mspeculatrix/McROM/Documentation/img/McROM-prog-hdr.png

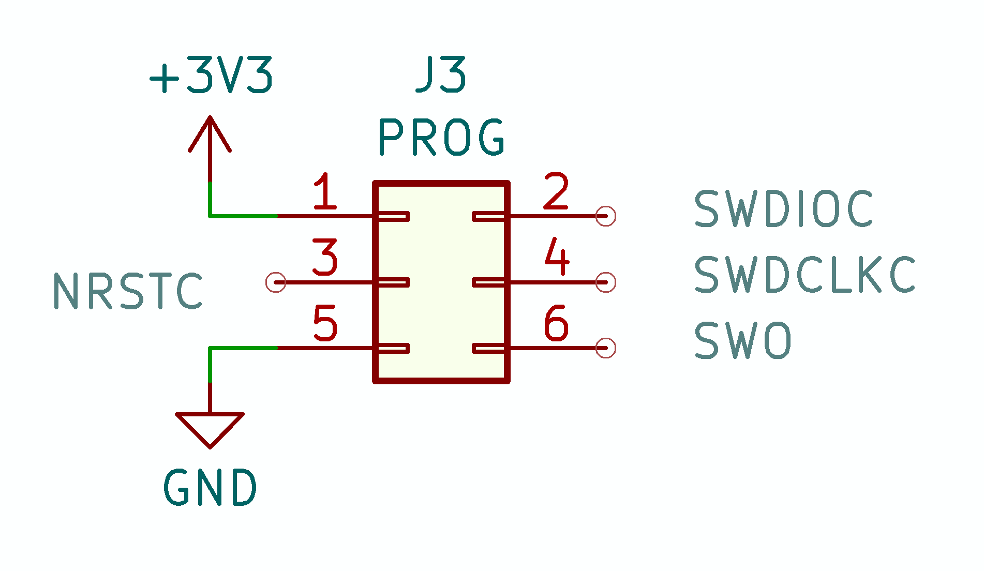
Documentation/img/McROM-prog-hdr.png
