mspeculatrix/McROM/Documentation/img/McROM-STM32H523CET-pinout.png

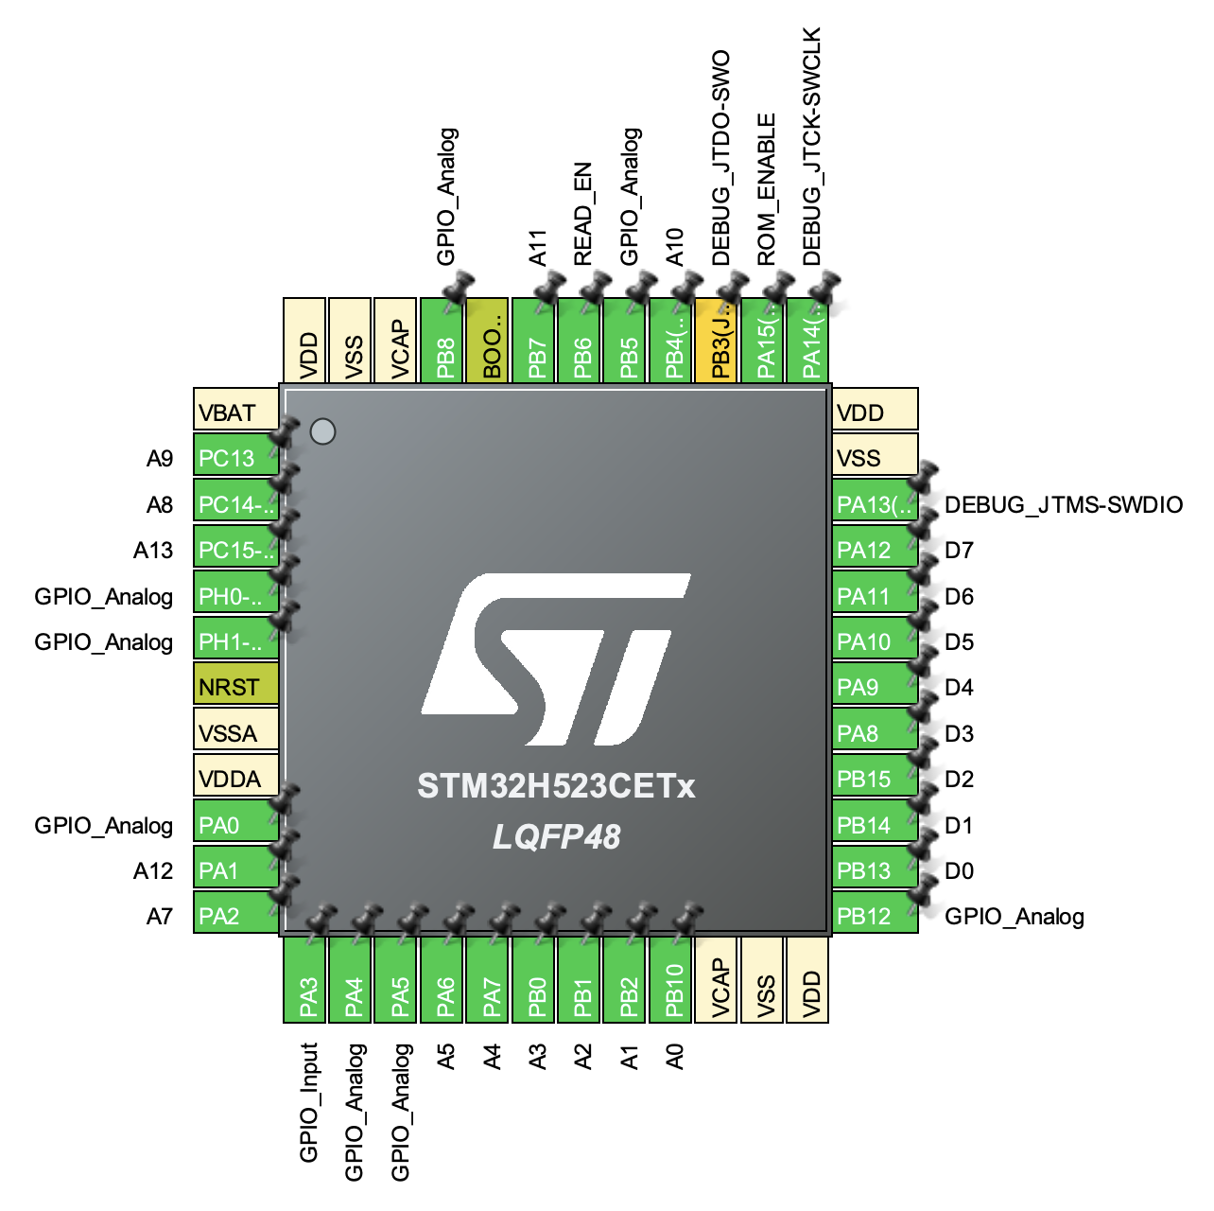
Documentation/img/McROM-STM32H523CET-pinout.png
