mspeculatrix/McROM/Documentation/img/McROM-SWD-header.png

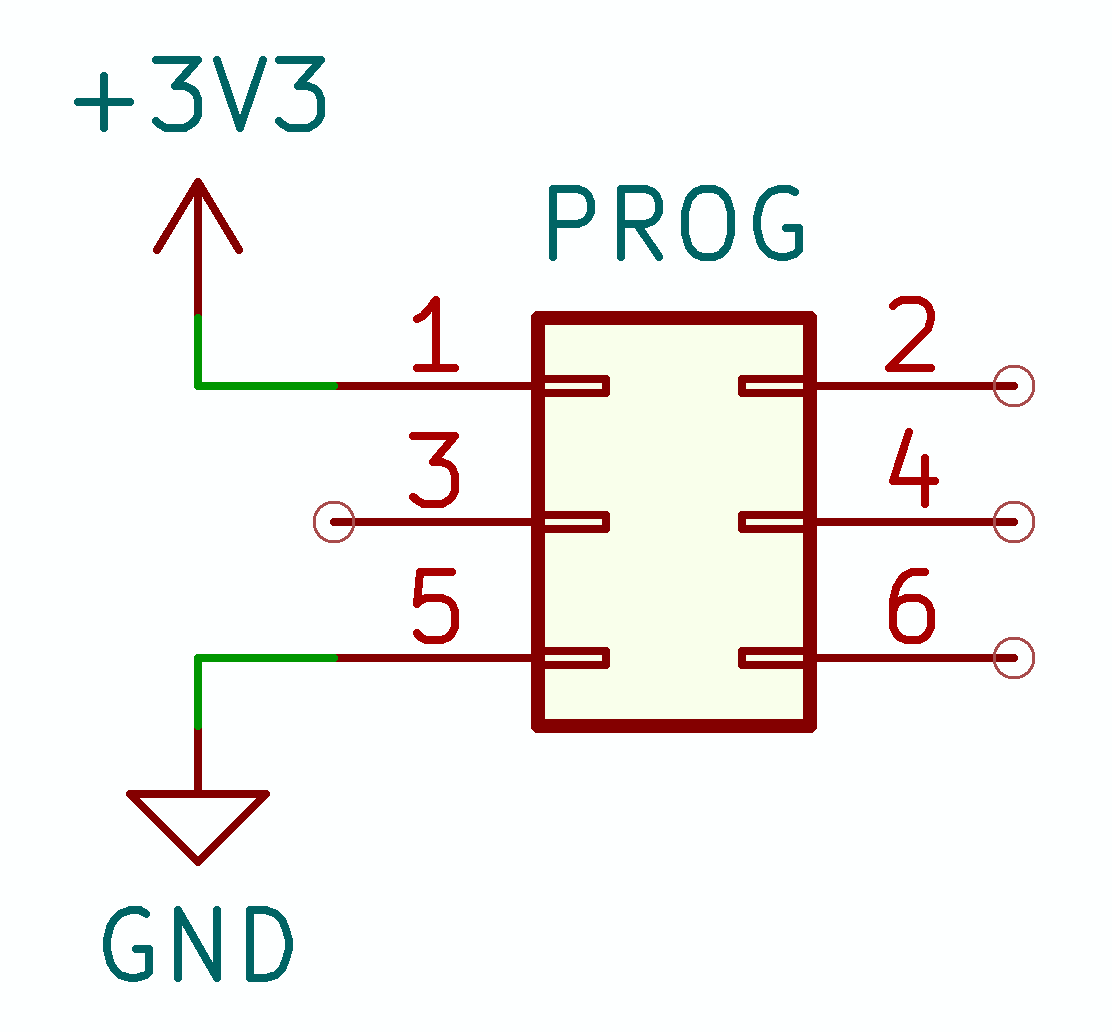
Documentation/img/McROM-SWD-header.png
