mspeculatrix/McROM/Documentation/img/Pin assignments.png

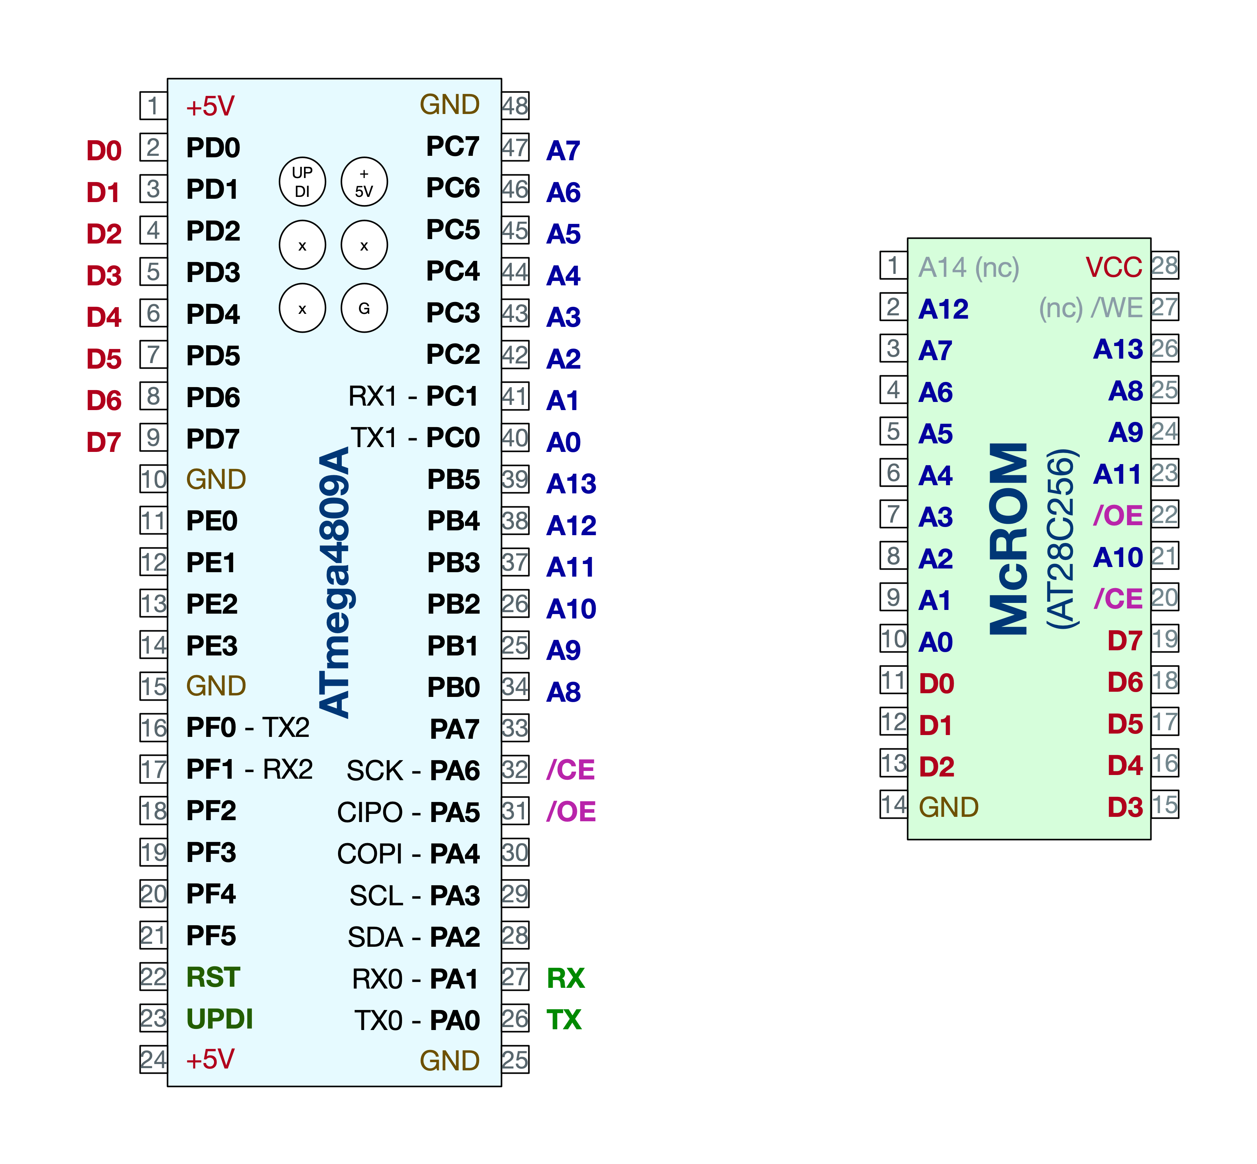
Documentation/img/Pin assignments.png
