mspeculatrix/McROM/Documentation/img/Programmer-connections.png

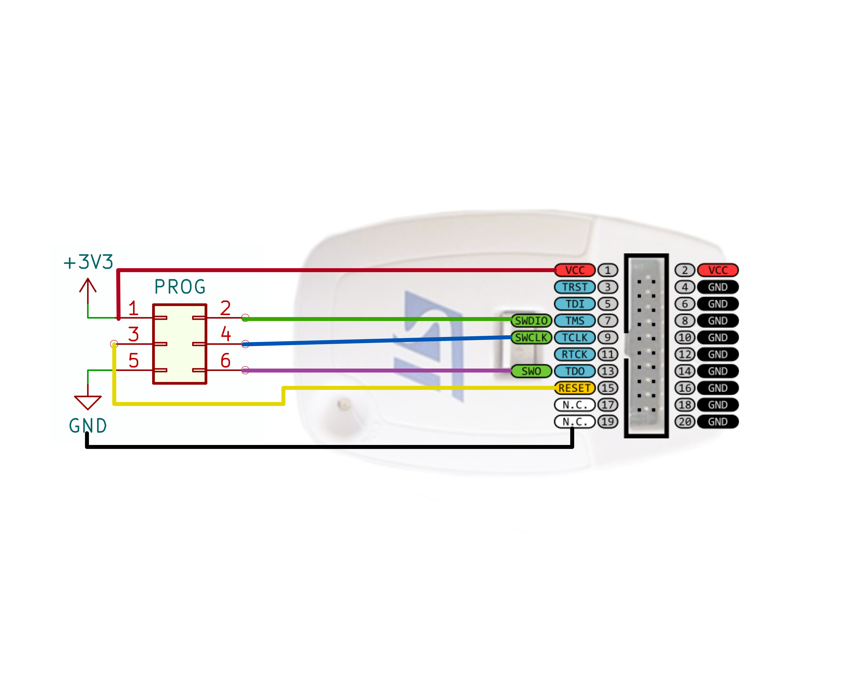
Documentation/img/Programmer-connections.png
