mspeculatrix/McROM/Documentation/McROM A1 schematic.jpg

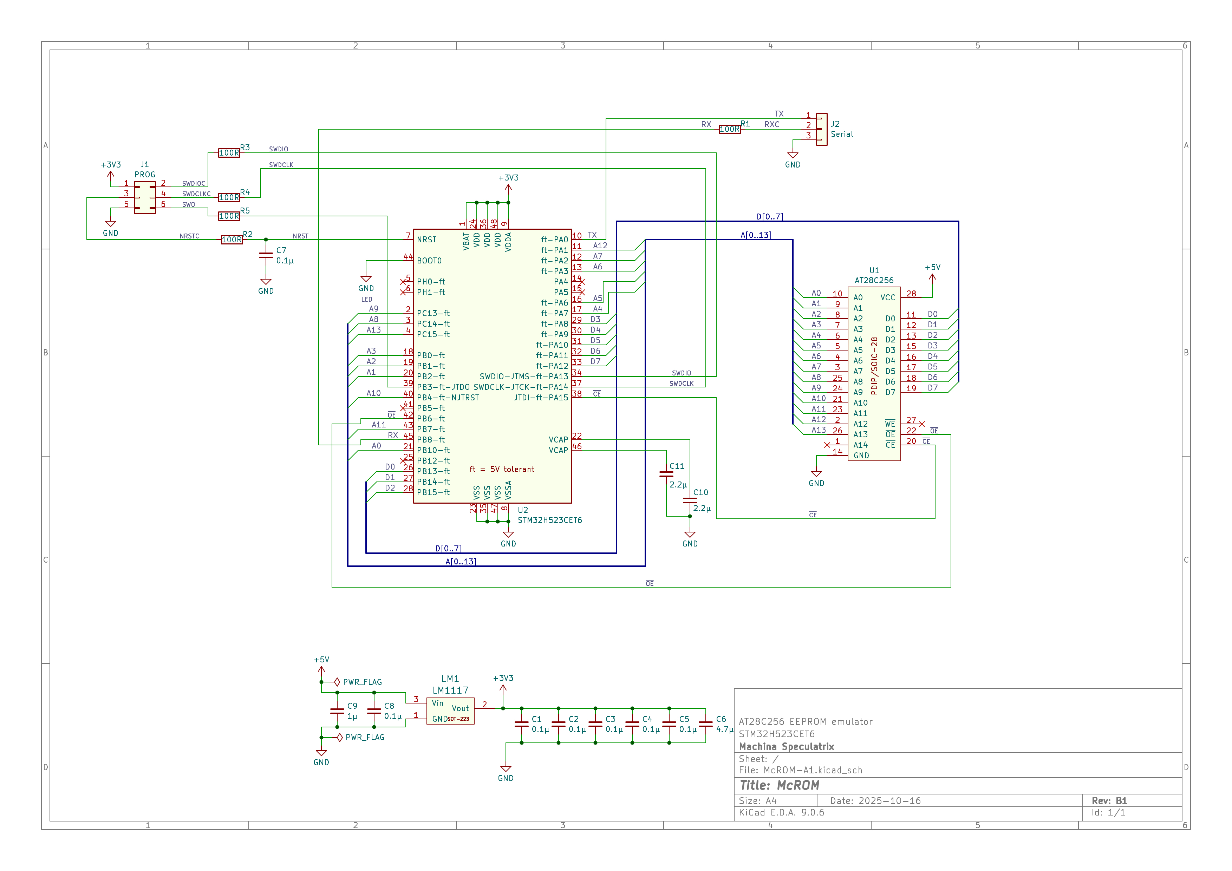
Documentation/McROM A1 schematic.jpg
