mspeculatrix/McROM/Documentation/McROM A2 schematic.jpg

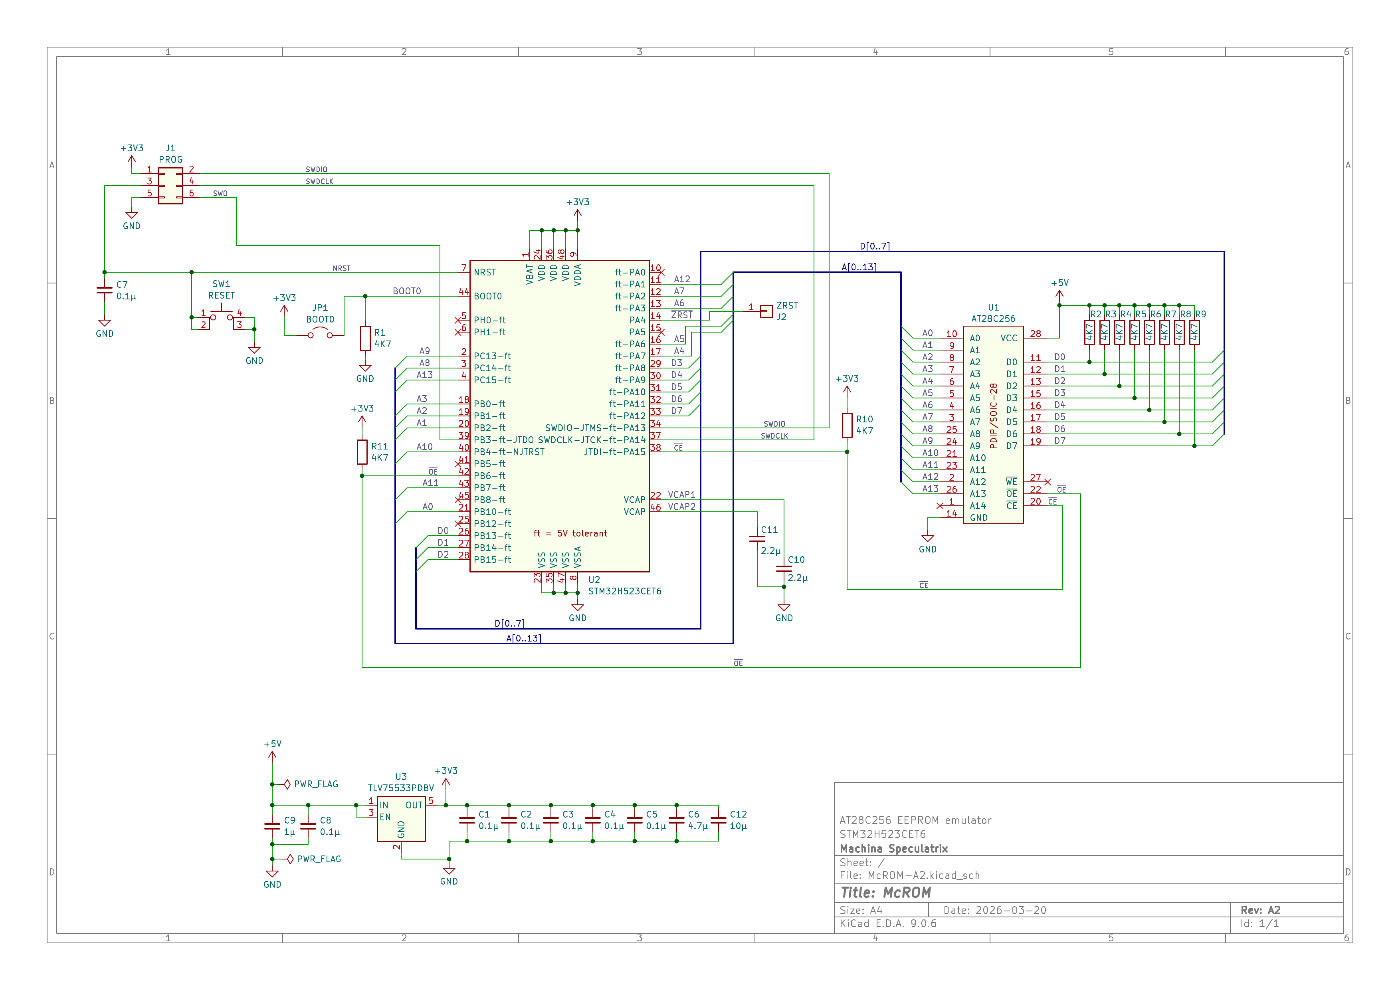
Documentation/McROM A2 schematic.jpg
