mspeculatrix/McROM/Core/Inc/main.h

#define A9_Pin GPIO_PIN_13
#define A9_GPIO_Port GPIOC
#define A8_Pin GPIO_PIN_14
#define A8_GPIO_Port GPIOC
#define A13_Pin GPIO_PIN_15
#define A13_GPIO_Port GPIOC
#define A12_Pin GPIO_PIN_1
#define A12_GPIO_Port GPIOA
#define A7_Pin GPIO_PIN_2
#define A7_GPIO_Port GPIOA
#define ZRST_Pin GPIO_PIN_4
#define ZRST_GPIO_Port GPIOA
#define A5_Pin GPIO_PIN_6
#define A5_GPIO_Port GPIOA
#define A4_Pin GPIO_PIN_7
#define A4_GPIO_Port GPIOA
#define A3_Pin GPIO_PIN_0
#define A3_GPIO_Port GPIOB
#define A2_Pin GPIO_PIN_1
#define A2_GPIO_Port GPIOB
#define A1_Pin GPIO_PIN_2
#define A1_GPIO_Port GPIOB
#define A0_Pin GPIO_PIN_10
#define A0_GPIO_Port GPIOB
#define D0_Pin GPIO_PIN_13
#define D0_GPIO_Port GPIOB
#define D1_Pin GPIO_PIN_14
#define D1_GPIO_Port GPIOB
#define D2_Pin GPIO_PIN_15
#define D2_GPIO_Port GPIOB
#define D3_Pin GPIO_PIN_8
#define D3_GPIO_Port GPIOA
#define D4_Pin GPIO_PIN_9
#define D4_GPIO_Port GPIOA
#define D5_Pin GPIO_PIN_10
#define D5_GPIO_Port GPIOA
#define D6_Pin GPIO_PIN_11
#define D6_GPIO_Port GPIOA
#define D7_Pin GPIO_PIN_12
#define D7_GPIO_Port GPIOA
#define ROM_ENABLE_Pin GPIO_PIN_15
#define ROM_ENABLE_GPIO_Port GPIOA
#define A10_Pin GPIO_PIN_4
#define A10_GPIO_Port GPIOB
#define READ_EN_Pin GPIO_PIN_6
#define READ_EN_GPIO_Port GPIOB
#define A11_Pin GPIO_PIN_7
#define A11_GPIO_Port GPIOB
