mspeculatrix/McROM/(commit log)

2026-03-30 Working version (if glitchy)
    [main.c]
2026-04-13 Cleaned up some minor errors
    [McROM.ioc, main.c, main.h]
